ClaudeMarais/FindEachOtherCompass_ESP32-C3/README.md

# Find Each Other Compass XIAO ESP32-C3
An Arduino project to create a compass that not only points North, but also points to another person. This is very useful for outdoor teams sports like Airsoft.

See detailed documentation in file Documentation.pdf

# Hardware
* XIAO ESP32-C3
* BN-880 GPS, which includes
* HMC5883 Magnetometer
* MPU6050 Accelerometer
* SSD1306 OLED Display
* External antenna
* Buzzer
* Battery
* Molle Tourniquet Pouch

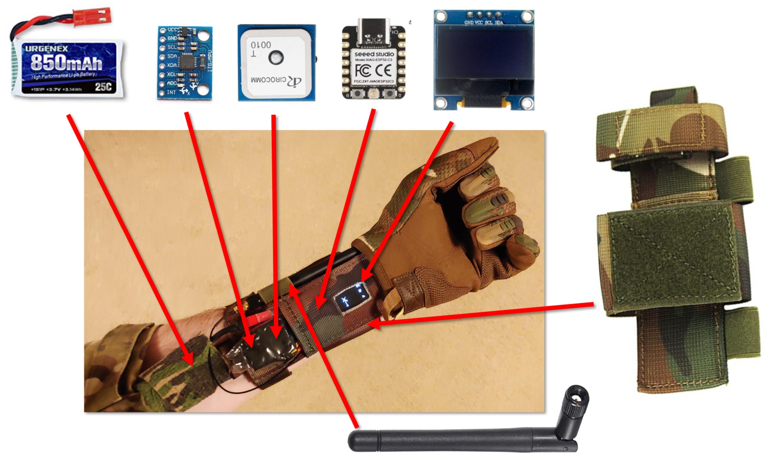
[picture p1: Images/image1.jpg]
