ClaudeMarais/FindEachOtherCompass_ESP32-C3/MagnetometerCalibration.xlsx

Device 0 | Expected | Actual | Delta 0 | Device 1 | Expected | Actual | Delta 1
 | -90 | -101 | 11 |  | -90 | -52 | -38
 | -45 | -66 | 21 |  | -45 | -15 | -30
 | 0 | -16 | 16 |  | 0 | 18 | -18
 | 45 | 44 | 1 |  | 45 | 45 | 0
 | 90 | 88 | 2 |  | 90 | 69 | 21
 | 135 | 128 | 7 |  | 135 | 92 | 43
 | 180 | 176 | 4 |  | 180 | 118 | 62
 | 225 | 223 | 2 |  | 225 | 209 | 16
 | 270 | 259 | 11 |  | 270 | 308 | -38
 | 315 | 294 | 21 |  | 315 | 345 | -30
 | 360 | 344 | 16 |  | 360 | 378 | -18
 | 405 | 404 | 1 |  | 405 | 405 | 0
